soujanya957/capstan-drive-leg/(list of files, cad)

Other CAD files:
CapstanPedal/ref_cad/Capstan-Drive_local/Test_Stand_Assembly.stp
CapstanPedal/ref_cad/TOPS_local/TOPS CAD Assembly.stp
CapstanPedal/fullbuild_v5/single_leg/print/0_Fit_Coupon.stl
CapstanPedal/ref_cad/moteus_r4_placed_A.stl
CapstanPedal/v9_1_buildable/assembly/leg_abad_gantry.step
CapstanPedal/v9_1_buildable/step/abad/Hip_Post.step
CapstanPedal/v9_1_buildable/step/leg_4bar/Leg4_Coupler.step
CapstanPedal/v9_1_buildable/step/mounts/Desk_Angle_Rear.step
CapstanPedal/v9_1_buildable/step/Test_Arm_A.step
CapstanPedal/ref_cad/moteus_r4_placed_B.stl
CapstanPedal/v9_1_buildable/assembly/leg.step
CapstanPedal/v9_1_buildable/step/abad/Hip_Trunnion.step
CapstanPedal/v9_1_buildable/step/leg_4bar/Leg4_Crank_NoGantry.step
CapstanPedal/v9_1_buildable/step/mounts/Desk_Angle_Front.step
CapstanPedal/v9_1_buildable/step/Post.step
CapstanPedal/ref_cad/eaglepower_8308.step
CapstanPedal/v9_1_buildable/assembly/leg_abad.step
CapstanPedal/v9_1_buildable/step/abad/Hip_Inner_Plate.step
CapstanPedal/v9_1_buildable/step/Big_Drum_B.step
CapstanPedal/v9_1_buildable/step/leg_4bar/Leg4_Foot.step
CapstanPedal/v9_1_buildable/step/mounts/Rail_Carriage.step
CapstanPedal/v9_1_buildable/assembly/flange.step
CapstanPedal/v9_1_buildable/step/abad/Hip_Front_Plate.step
CapstanPedal/v9_1_buildable/step/End_Bracket.step
CapstanPedal/v9_1_buildable/step/leg_4bar/Leg4_Crank.step
CapstanPedal/v9_1_buildable/step/mounts/Desk_Base.step
CapstanPedal/v9_1_buildable/assembly/flange_abad.step
CapstanPedal/v9_1_buildable/step/abad/Hip_Outer_Plate.step
CapstanPedal/v9_1_buildable/step/leg_4bar/Leg4_Shin.step
CapstanPedal/v9_1_buildable/step/Motor_Plate.step
CapstanPedal/v9_1_buildable/assembly/leg_gantry.step
CapstanPedal/v9_1_buildable/step/abad/Hip_Spine.step
CapstanPedal/v9_1_buildable/step/Gantry_Post.step
CapstanPedal/v9_1_buildable/step/leg_4bar/Leg4_Foot_Core_A.step
CapstanPedal/v9_1_buildable/assembly/flange_abad_gantry.step
CapstanPedal/v9_1_buildable/step/abad/Abad_Small_Drum.step
CapstanPedal/v9_1_buildable/step/leg_4bar/Leg4_Shin_Plate_Back.step
CapstanPedal/v9_1_buildable/step/Output_Flange_A.step
CapstanPedal/v9_1_buildable/assembly/flange_gantry.step
CapstanPedal/v9_1_buildable/step/abad/Abad_Drum.step
CapstanPedal/v9_1_buildable/step/leg_4bar/Leg4_Shin_Plate_Front.step
CapstanPedal/v9_1_buildable/step/Small_Drum_B.step
CapstanPedal/v9_1_buildable/step/abad/End_Bracket_Front.step
CapstanPedal/v9_1_buildable/step/leg_4bar/Leg4_Foot_Core_B.step
CapstanPedal/v9_1_buildable/step/Small_Drum_A.step
CapstanPedal/v9_1_buildable/step/Big_Drum_A.step
CapstanPedal/v9_1_buildable/step/leg_4bar/Leg4_Thigh.step
CapstanPedal/v9_1_buildable/step/Gantry.step
CapstanPedal/v9_1_buildable/step/Front_Wall.step
CapstanPedal/v9_1_buildable/step/Output_Flange_B.step
CapstanPedal/v9_1_buildable/step/Top_Rail.step
CapstanPedal/v9_1_buildable/step/Test_Arm_A_Gantry.step
CapstanPedal/v9_1_buildable/step/A_Shaft_Cap.step
CapstanPedal/v9_1_buildable/step/Test_Arm_B.step
CapstanPedal/fullbuild_v3/urdf/meshes/coupler_LF__red.stl
CapstanPedal/fullbuild_v3/urdf/meshes/coupler_LR__red.stl
CapstanPedal/fullbuild_v3/urdf/meshes/coupler_RF__red.stl
CapstanPedal/fullbuild_v3/urdf/meshes/coupler_RR__red.stl
CapstanPedal/fullbuild_v3/urdf/meshes/crank_LF__brass.stl
CapstanPedal/fullbuild_v3/urdf/meshes/crank_LF__red.stl
CapstanPedal/fullbuild_v3/urdf/meshes/crank_LF__screw.stl
CapstanPedal/fullbuild_v3/urdf/meshes/crank_LF__steel.stl
CapstanPedal/fullbuild_v3/urdf/meshes/crank_LF__teal.stl
CapstanPedal/fullbuild_v3/urdf/meshes/crank_LR__brass.stl
CapstanPedal/fullbuild_v3/urdf/meshes/crank_LR__red.stl
CapstanPedal/fullbuild_v3/urdf/meshes/crank_LR__screw.stl
CapstanPedal/fullbuild_v3/urdf/meshes/crank_LR__steel.stl
CapstanPedal/fullbuild_v3/urdf/meshes/crank_LR__teal.stl
CapstanPedal/fullbuild_v3/urdf/meshes/crank_RF__brass.stl
CapstanPedal/fullbuild_v3/urdf/meshes/crank_RF__red.stl
CapstanPedal/fullbuild_v3/urdf/meshes/crank_RF__screw.stl
CapstanPedal/fullbuild_v3/urdf/meshes/crank_RF__steel.stl
CapstanPedal/fullbuild_v3/urdf/meshes/crank_RF__teal.stl
CapstanPedal/fullbuild_v3/urdf/meshes/crank_RR__brass.stl
CapstanPedal/fullbuild_v3/urdf/meshes/crank_RR__red.stl
CapstanPedal/fullbuild_v3/urdf/meshes/crank_RR__screw.stl
CapstanPedal/fullbuild_v3/urdf/meshes/crank_RR__steel.stl
CapstanPedal/fullbuild_v3/urdf/meshes/crank_RR__teal.stl
CapstanPedal/fullbuild_v3/urdf/meshes/pod_LF__black.stl
CapstanPedal/fullbuild_v3/urdf/meshes/pod_LF__brass.stl
CapstanPedal/fullbuild_v3/urdf/meshes/pod_LF__dimgray.stl
CapstanPedal/fullbuild_v3/urdf/meshes/pod_LF__motor_dark.stl
CapstanPedal/fullbuild_v3/urdf/meshes/pod_LF__red.stl
CapstanPedal/fullbuild_v3/urdf/meshes/pod_LF__screw.stl
CapstanPedal/fullbuild_v3/urdf/meshes/pod_LF__steel.stl
CapstanPedal/fullbuild_v3/urdf/meshes/pod_LF__violet.stl
CapstanPedal/fullbuild_v3/urdf/meshes/pod_LR__black.stl
CapstanPedal/fullbuild_v3/urdf/meshes/pod_LR__brass.stl
CapstanPedal/fullbuild_v3/urdf/meshes/pod_LR__dimgray.stl
CapstanPedal/fullbuild_v3/urdf/meshes/pod_LR__motor_dark.stl
CapstanPedal/fullbuild_v3/urdf/meshes/pod_LR__red.stl
CapstanPedal/fullbuild_v3/urdf/meshes/pod_LR__screw.stl
CapstanPedal/fullbuild_v3/urdf/meshes/pod_LR__steel.stl
CapstanPedal/fullbuild_v3/urdf/meshes/pod_LR__violet.stl
CapstanPedal/fullbuild_v3/urdf/meshes/pod_RF__black.stl
CapstanPedal/fullbuild_v3/urdf/meshes/pod_RF__brass.stl
CapstanPedal/fullbuild_v3/urdf/meshes/pod_RF__dimgray.stl
CapstanPedal/fullbuild_v3/urdf/meshes/pod_RF__motor_dark.stl
CapstanPedal/fullbuild_v3/urdf/meshes/pod_RF__red.stl
CapstanPedal/fullbuild_v3/urdf/meshes/pod_RF__screw.stl
CapstanPedal/fullbuild_v3/urdf/meshes/pod_RF__steel.stl
CapstanPedal/fullbuild_v3/urdf/meshes/pod_RF__violet.stl
CapstanPedal/fullbuild_v3/urdf/meshes/pod_RR__black.stl
CapstanPedal/fullbuild_v3/urdf/meshes/pod_RR__brass.stl
CapstanPedal/fullbuild_v3/urdf/meshes/pod_RR__dimgray.stl
CapstanPedal/fullbuild_v3/urdf/meshes/pod_RR__motor_dark.stl
CapstanPedal/fullbuild_v3/urdf/meshes/pod_RR__red.stl
CapstanPedal/fullbuild_v3/urdf/meshes/pod_RR__screw.stl
CapstanPedal/fullbuild_v3/urdf/meshes/pod_RR__steel.stl
CapstanPedal/fullbuild_v3/urdf/meshes/pod_RR__violet.stl
CapstanPedal/fullbuild_v3/urdf/meshes/rotorA_LF__magnet.stl
CapstanPedal/fullbuild_v3/urdf/meshes/rotorA_LF__motor.stl
CapstanPedal/fullbuild_v3/urdf/meshes/rotorA_LF__screw.stl
CapstanPedal/fullbuild_v3/urdf/meshes/rotorA_LF__silver.stl
CapstanPedal/fullbuild_v3/urdf/meshes/rotorA_LF__steel.stl
CapstanPedal/fullbuild_v3/urdf/meshes/rotorA_LR__magnet.stl
CapstanPedal/fullbuild_v3/urdf/meshes/rotorA_LR__motor.stl
CapstanPedal/fullbuild_v3/urdf/meshes/rotorA_LR__screw.stl
CapstanPedal/fullbuild_v3/urdf/meshes/rotorA_LR__silver.stl
CapstanPedal/fullbuild_v3/urdf/meshes/rotorA_LR__steel.stl
CapstanPedal/fullbuild_v3/urdf/meshes/rotorA_RF__magnet.stl
CapstanPedal/fullbuild_v3/urdf/meshes/rotorA_RF__motor.stl
CapstanPedal/fullbuild_v3/urdf/meshes/rotorA_RF__screw.stl
CapstanPedal/fullbuild_v3/urdf/meshes/rotorA_RF__silver.stl
CapstanPedal/fullbuild_v3/urdf/meshes/rotorA_RF__steel.stl
CapstanPedal/fullbuild_v3/urdf/meshes/rotorA_RR__magnet.stl
CapstanPedal/fullbuild_v3/urdf/meshes/rotorA_RR__motor.stl
CapstanPedal/fullbuild_v3/urdf/meshes/rotorA_RR__screw.stl
CapstanPedal/fullbuild_v3/urdf/meshes/rotorA_RR__silver.stl
CapstanPedal/fullbuild_v3/urdf/meshes/rotorA_RR__steel.stl
CapstanPedal/fullbuild_v3/urdf/meshes/rotorB_LF__magnet.stl
CapstanPedal/fullbuild_v3/urdf/meshes/rotorB_LF__motor.stl
CapstanPedal/fullbuild_v3/urdf/meshes/rotorB_LF__screw.stl
CapstanPedal/fullbuild_v3/urdf/meshes/rotorB_LF__silver.stl
CapstanPedal/fullbuild_v3/urdf/meshes/rotorB_LF__steel.stl
CapstanPedal/fullbuild_v3/urdf/meshes/rotorB_LR__magnet.stl
CapstanPedal/fullbuild_v3/urdf/meshes/rotorB_LR__motor.stl
CapstanPedal/fullbuild_v3/urdf/meshes/rotorB_LR__screw.stl
CapstanPedal/fullbuild_v3/urdf/meshes/rotorB_LR__silver.stl
CapstanPedal/fullbuild_v3/urdf/meshes/rotorB_LR__steel.stl
CapstanPedal/fullbuild_v3/urdf/meshes/rotorB_RF__magnet.stl
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
