soujanya957/capstan-drive-leg/CapstanPedal/fullbuild_v4/urdf/capstan_quad.urdf

<?xml version="1.0"?>
<!-- Capstan quadruped v3 (v9.1 legs): generated by build_urdf.py from the CAD -->
<robot name="capstan_quad">
  <material name="amber"><color rgba="0.930 0.520 0.120 1.0"/></material>
  <material name="black"><color rgba="0.110 0.110 0.120 1.0"/></material>
  <material name="blue"><color rgba="0.120 0.300 0.850 1.0"/></material>
  <material name="brass"><color rgba="0.860 0.660 0.280 1.0"/></material>
  <material name="cf"><color rgba="0.090 0.090 0.100 1.0"/></material>
  <material name="dimgray"><color rgba="0.380 0.390 0.410 1.0"/></material>
  <material name="magnet"><color rgba="0.720 0.730 0.760 1.0"/></material>
  <material name="motor"><color rgba="0.740 0.550 0.200 1.0"/></material>
  <material name="motor_dark"><color rgba="0.300 0.300 0.320 1.0"/></material>
  <material name="pcb"><color rgba="0.150 0.450 0.300 1.0"/></material>
  <material name="purple"><color rgba="0.360 0.200 0.550 1.0"/></material>
  <material name="red"><color rgba="0.800 0.220 0.170 1.0"/></material>
  <material name="screw"><color rgba="0.800 0.810 0.840 1.0"/></material>
  <material name="silver"><color rgba="0.800 0.810 0.830 1.0"/></material>
  <material name="steel"><color rgba="0.620 0.660 0.720 1.0"/></material>
  <material name="teal"><color rgba="0.100 0.560 0.580 1.0"/></material>
  <material name="violet"><color rgba="0.470 0.320 0.700 1.0"/></material>
  <material name="white"><color rgba="0.930 0.930 0.900 1.0"/></material>
  <material name="yellow"><color rgba="0.930 0.740 0.180 1.0"/></material>
  <link name="torso">
    <inertial><origin xyz="-0.00001 0.00117 -0.01315"/><mass value="5.6471"/><inertia ixx="0.0662936" ixy="4.0156e-06" ixz="-1.92121e-06" iyy="0.130849" iyz="-1.42409e-05" izz="0.146887"/></inertial>
    <visual><geometry><mesh filename="meshes/torso__black.obj"/></geometry><material name="black"/></visual>
    <visual><geometry><mesh filename="meshes/torso__blue.obj"/></geometry><material name="blue"/></visual>
    <visual><geometry><mesh filename="meshes/torso__brass.obj"/></geometry><material name="brass"/></visual>
    <visual><geometry><mesh filename="meshes/torso__cf.obj"/></geometry><material name="cf"/></visual>
    <visual><geometry><mesh filename="meshes/torso__dimgray.obj"/></geometry><material name="dimgray"/></visual>
    <visual><geometry><mesh filename="meshes/torso__motor_dark.obj"/></geometry><material name="motor_dark"/></visual>
    <visual><geometry><mesh filename="meshes/torso__pcb.obj"/></geometry><material name="pcb"/></visual>
    <visual><geometry><mesh filename="meshes/torso__purple.obj"/></geometry><material name="purple"/></visual>
    <visual><geometry><mesh filename="meshes/torso__red.obj"/></geometry><material name="red"/></visual>
    <visual><geometry><mesh filename="meshes/torso__screw.obj"/></geometry><material name="screw"/></visual>
    <visual><geometry><mesh filename="meshes/torso__silver.obj"/></geometry><material name="silver"/></visual>
    <visual><geometry><mesh filename="meshes/torso__steel.obj"/></geometry><material name="steel"/></visual>
    <visual><geometry><mesh filename="meshes/torso__white.obj"/></geometry><material name="white"/></visual>
    <visual><geometry><mesh filename="meshes/torso__yellow.obj"/></geometry><material name="yellow"/></visual>
    <collision><origin xyz="0 0 -0.0325"/><geometry><box size="0.69 0.26 0.22"/></geometry></collision>
  </link>
  <link name="pod_LF">
    <inertial><origin xyz="-0.01137 -0.00158 0.04767"/><mass value="2.4610"/><inertia ixx="0.00820475" ixy="0.00047916" ixz="-0.000741235" iyy="0.0148086" iyz="0.00055981" izz="0.0150834"/></inertial>
    <visual><geometry><mesh filename="meshes/pod_LF__black.obj"/></geometry><material name="black"/></visual>
    <visual><geometry><mesh filename="meshes/pod_LF__brass.obj"/></geometry><material name="brass"/></visual>
    <visual><geometry><mesh filename="meshes/pod_LF__dimgray.obj"/></geometry><material name="dimgray"/></visual>
    <visual><geometry><mesh filename="meshes/pod_LF__motor_dark.obj"/></geometry><material name="motor_dark"/></visual>
    <visual><geometry><mesh filename="meshes/pod_LF__red.obj"/></geometry><material name="red"/></visual>
    <visual><geometry><mesh filename="meshes/pod_LF__screw.obj"/></geometry><material name="screw"/></visual>
    <visual><geometry><mesh filename="meshes/pod_LF__steel.obj"/></geometry><material name="steel"/></visual>
    <visual><geometry><mesh filename="meshes/pod_LF__violet.obj"/></geometry><material name="violet"/></visual>
    <collision><origin xyz="-0.0315 0.0140 0.0300"/><geometry><box size="0.26 0.10 0.17"/></geometry></collision>
  </link>
  <link name="thigh_LF">
    <inertial><origin xyz="0.03341 -0.02143 -0.05619"/><mass value="0.2851"/><inertia ixx="0.00195796" ixy="-0.00016787" ixz="0.000971859" iyy="0.00258889" iyz="0.00030171" izz="0.000858487"/></inertial>
    <visual><geometry><mesh filename="meshes/thigh_LF__amber.obj"/></geometry><material name="amber"/></visual>
    <visual><geometry><mesh filename="meshes/thigh_LF__black.obj"/></geometry><material name="black"/></visual>
    <visual><geometry><mesh filename="meshes/thigh_LF__brass.obj"/></geometry><material name="brass"/></visual>
    <visual><geometry><mesh filename="meshes/thigh_LF__red.obj"/></geometry><material name="red"/></visual>
    <visual><geometry><mesh filename="meshes/thigh_LF__screw.obj"/></geometry><material name="screw"/></visual>
    <visual><geometry><mesh filename="meshes/thigh_LF__steel.obj"/></geometry><material name="steel"/></visual>
    <collision><origin xyz="0.05000 0.00000 -0.08660" rpy="0 2.61799 0"/><geometry><cylinder radius="0.014" length="0.20000"/></geometry></collision>
  </link>
  <link name="crank_LF">
    <inertial><origin xyz="0.00621 -0.04210 0.00658"/><mass value="0.2398"/><inertia ixx="0.00064813" ixy="-9.52676e-05" ixz="-7.57725e-05" iyy="0.000393976" iyz="-6.97606e-05" izz="0.000693556"/></inertial>
    <visual><geometry><mesh filename="meshes/crank_LF__brass.obj"/></geometry><material name="brass"/></visual>
    <visual><geometry><mesh filename="meshes/crank_LF__red.obj"/></geometry><material name="red"/></visual>
    <visual><geometry><mesh filename="meshes/crank_LF__screw.obj"/></geometry><material name="screw"/></visual>
    <visual><geometry><mesh filename="meshes/crank_LF__steel.obj"/></geometry><material name="steel"/></visual>
    <visual><geometry><mesh filename="meshes/crank_LF__teal.obj"/></geometry><material name="teal"/></visual>
  </link>
  <link name="rotorA_LF">
    <inertial><mass value="0.001"/><inertia ixx="1e-7" ixy="0" ixz="0" iyy="1e-7" iyz="0" izz="1e-7"/></inertial>
    <visual><geometry><mesh filename="meshes/rotorA_LF__magnet.obj"/></geometry><material name="magnet"/></visual>
    <visual><geometry><mesh filename="meshes/rotorA_LF__motor.obj"/></geometry><material name="motor"/></visual>
    <visual><geometry><mesh filename="meshes/rotorA_LF__screw.obj"/></geometry><material name="screw"/></visual>
    <visual><geometry><mesh filename="meshes/rotorA_LF__silver.obj"/></geometry><material name="silver"/></visual>
    <visual><geometry><mesh filename="meshes/rotorA_LF__steel.obj"/></geometry><material name="steel"/></visual>
  </link>
  <link name="rotorB_LF">
    <inertial><mass value="0.001"/><inertia ixx="1e-7" ixy="0" ixz="0" iyy="1e-7" iyz="0" izz="1e-7"/></inertial>
    <visual><geometry><mesh filename="meshes/rotorB_LF__magnet.obj"/></geometry><material name="magnet"/></visual>
    <visual><geometry><mesh filename="meshes/rotorB_LF__motor.obj"/></geometry><material name="motor"/></visual>
    <visual><geometry><mesh filename="meshes/rotorB_LF__screw.obj"/></geometry><material name="screw"/></visual>
    <visual><geometry><mesh filename="meshes/rotorB_LF__silver.obj"/></geometry><material name="silver"/></visual>
    <visual><geometry><mesh filename="meshes/rotorB_LF__steel.obj"/></geometry><material name="steel"/></visual>
  </link>
  <link name="rotorC_LF">
    <inertial><mass value="0.001"/><inertia ixx="1e-7" ixy="0" ixz="0" iyy="1e-7" iyz="0" izz="1e-7"/></inertial>
    <visual><geometry><mesh filename="meshes/rotorC_LF__magnet.obj"/></geometry><material name="magnet"/></visual>
    <visual><geometry><mesh filename="meshes/rotorC_LF__motor.obj"/></geometry><material name="motor"/></visual>
    <visual><geometry><mesh filename="meshes/rotorC_LF__screw.obj"/></geometry><material name="screw"/></visual>
    <visual><geometry><mesh filename="meshes/rotorC_LF__silver.obj"/></geometry><material name="silver"/></visual>
    <visual><geometry><mesh filename="meshes/rotorC_LF__steel.obj"/></geometry><material name="steel"/></visual>
  </link>
  <link name="coupler_LF">
    <inertial><origin xyz="0.06061 0.01509 -0.10083"/><mass value="0.0572"/><inertia ixx="0.00013777" ixy="4.23738e-07" ixz="6.66021e-05" iyy="0.000179031" iyz="-9.49691e-07" izz="4.23388e-05"/></inertial>
    <visual><geometry><mesh filename="meshes/coupler_LF__red.obj"/></geometry><material name="red"/></visual>
  </link>
  <link name="shin_LF">
    <inertial><origin xyz="-0.05754 -0.00033 -0.10353"/><mass value="0.2235"/><inertia ixx="0.00164671" ixy="-1.44123e-05" ixz="-0.00104536" iyy="0.00234251" iyz="-2.04071e-05" izz="0.000729452"/></inertial>
    <visual><geometry><mesh filename="meshes/shin_LF__black.obj"/></geometry><material name="black"/></visual>
    <visual><geometry><mesh filename="meshes/shin_LF__brass.obj"/></geometry><material name="brass"/></visual>
    <visual><geometry><mesh filename="meshes/shin_LF__dimgray.obj"/></geometry><material name="dimgray"/></visual>
    <visual><geometry><mesh filename="meshes/shin_LF__red.obj"/></geometry><material name="red"/></visual>
    <visual><geometry><mesh filename="meshes/shin_LF__screw.obj"/></geometry><material name="screw"/></visual>
    <visual><geometry><mesh filename="meshes/shin_LF__steel.obj"/></geometry><material name="steel"/></visual>
    <collision><origin xyz="-0.04250 0.00000 -0.07361" rpy="0 -2.61799 0"/><geometry><cylinder radius="0.012" length="0.17000"/></geometry></collision>
    <collision name="foot_LF"><origin xyz="-0.10000 0 -0.17321"/><geometry><sphere radius="0.023"/></geometry></collision>
  </link>
  <link name="pod_LR">
    <inertial><origin xyz="0.00733 -0.00158 0.04767"/><mass value="2.4610"/><inertia ixx="0.00820475" ixy="0.000372214" ixz="0.000669965" iyy="0.0149946" iyz="0.00055981" izz="0.0152693"/></inertial>
    <visual><geometry><mesh filename="meshes/pod_LR__black.obj"/></geometry><material name="black"/></visual>
    <visual><geometry><mesh filename="meshes/pod_LR__brass.obj"/></geometry><material name="brass"/></visual>
    <visual><geometry><mesh filename="meshes/pod_LR__dimgray.obj"/></geometry><material name="dimgray"/></visual>
    <visual><geometry><mesh filename="meshes/pod_LR__motor_dark.obj"/></geometry><material name="motor_dark"/></visual>
    <visual><geometry><mesh filename="meshes/pod_LR__red.obj"/></geometry><material name="red"/></visual>
    <visual><geometry><mesh filename="meshes/pod_LR__screw.obj"/></geometry><material name="screw"/></visual>
    <visual><geometry><mesh filename="meshes/pod_LR__steel.obj"/></geometry><material name="steel"/></visual>
    <visual><geometry><mesh filename="meshes/pod_LR__violet.obj"/></geometry><material name="violet"/></visual>
    <collision><origin xyz="0.0315 0.0140 0.0300"/><geometry><box size="0.26 0.10 0.17"/></geometry></collision>
  </link>
  <link name="thigh_LR">
    <inertial><origin xyz="0.03341 -0.02143 -0.05619"/><mass value="0.2851"/><inertia ixx="0.00195796" ixy="-0.00016787" ixz="0.000971859" iyy="0.00258889" iyz="0.00030171" izz="0.000858487"/></inertial>
    <visual><geometry><mesh filename="meshes/thigh_LR__amber.obj"/></geometry><material name="amber"/></visual>
    <visual><geometry><mesh filename="meshes/thigh_LR__black.obj"/></geometry><material name="black"/></visual>
    <visual><geometry><mesh filename="meshes/thigh_LR__brass.obj"/></geometry><material name="brass"/></visual>
    <visual><geometry><mesh filename="meshes/thigh_LR__red.obj"/></geometry><material name="red"/></visual>
    <visual><geometry><mesh filename="meshes/thigh_LR__screw.obj"/></geometry><material name="screw"/></visual>
    <visual><geometry><mesh filename="meshes/thigh_LR__steel.obj"/></geometry><material name="steel"/></visual>
    <collision><origin xyz="0.05000 0.00000 -0.08660" rpy="0 2.61799 0"/><geometry><cylinder radius="0.014" length="0.20000"/></geometry></collision>
  </link>
  <link name="crank_LR">
    <inertial><origin xyz="0.00621 -0.04210 0.00658"/><mass value="0.2398"/><inertia ixx="0.00064813" ixy="-9.52676e-05" ixz="-7.57725e-05" iyy="0.000393976" iyz="-6.97606e-05" izz="0.000693556"/></inertial>
    <visual><geometry><mesh filename="meshes/crank_LR__brass.obj"/></geometry><material name="brass"/></visual>
    <visual><geometry><mesh filename="meshes/crank_LR__red.obj"/></geometry><material name="red"/></visual>
    <visual><geometry><mesh filename="meshes/crank_LR__screw.obj"/></geometry><material name="screw"/></visual>
    <visual><geometry><mesh filename="meshes/crank_LR__steel.obj"/></geometry><material name="steel"/></visual>
    <visual><geometry><mesh filename="meshes/crank_LR__teal.obj"/></geometry><material name="teal"/></visual>
  </link>
  <link name="rotorA_LR">
    <inertial><mass value="0.001"/><inertia ixx="1e-7" ixy="0" ixz="0" iyy="1e-7" iyz="0" izz="1e-7"/></inertial>
    <visual><geometry><mesh filename="meshes/rotorA_LR__magnet.obj"/></geometry><material name="magnet"/></visual>
    <visual><geometry><mesh filename="meshes/rotorA_LR__motor.obj"/></geometry><material name="motor"/></visual>
    <visual><geometry><mesh filename="meshes/rotorA_LR__screw.obj"/></geometry><material name="screw"/></visual>
    <visual><geometry><mesh filename="meshes/rotorA_LR__silver.obj"/></geometry><material name="silver"/></visual>
    <visual><geometry><mesh filename="meshes/rotorA_LR__steel.obj"/></geometry><material name="steel"/></visual>
  </link>
  <link name="rotorB_LR">
    <inertial><mass value="0.001"/><inertia ixx="1e-7" ixy="0" ixz="0" iyy="1e-7" iyz="0" izz="1e-7"/></inertial>
    <visual><geometry><mesh filename="meshes/rotorB_LR__magnet.obj"/></geometry><material name="magnet"/></visual>
    <visual><geometry><mesh filename="meshes/rotorB_LR__motor.obj"/></geometry><material name="motor"/></visual>
    <visual><geometry><mesh filename="meshes/rotorB_LR__screw.obj"/></geometry><material name="screw"/></visual>
    <visual><geometry><mesh filename="meshes/rotorB_LR__silver.obj"/></geometry><material name="silver"/></visual>
    <visual><geometry><mesh filename="meshes/rotorB_LR__steel.obj"/></geometry><material name="steel"/></visual>
  </link>
  <link name="rotorC_LR">
    <inertial><mass value="0.001"/><inertia ixx="1e-7" ixy="0" ixz="0" iyy="1e-7" iyz="0" izz="1e-7"/></inertial>
    <visual><geometry><mesh filename="meshes/rotorC_LR__magnet.obj"/></geometry><material name="magnet"/></visual>
    <visual><geometry><mesh filename="meshes/rotorC_LR__motor.obj"/></geometry><material name="motor"/></visual>
    <visual><geometry><mesh filename="meshes/rotorC_LR__screw.obj"/></geometry><material name="screw"/></visual>
    <visual><geometry><mesh filename="meshes/rotorC_LR__silver.obj"/></geometry><material name="silver"/></visual>
    <visual><geometry><mesh filename="meshes/rotorC_LR__steel.obj"/></geometry><material name="steel"/></visual>
  </link>
  <link name="coupler_LR">
    <inertial><origin xyz="0.06061 0.01509 -0.10083"/><mass value="0.0572"/><inertia ixx="0.00013777" ixy="4.23738e-07" ixz="6.66021e-05" iyy="0.000179031" iyz="-9.49691e-07" izz="4.23388e-05"/></inertial>
    <visual><geometry><mesh filename="meshes/coupler_LR__red.obj"/></geometry><material name="red"/></visual>
  </link>
  <link name="shin_LR">
    <inertial><origin xyz="-0.05754 -0.00033 -0.10353"/><mass value="0.2235"/><inertia ixx="0.00164671" ixy="-1.44123e-05" ixz="-0.00104536" iyy="0.00234251" iyz="-2.04071e-05" izz="0.000729452"/></inertial>
    <visual><geometry><mesh filename="meshes/shin_LR__black.obj"/></geometry><material name="black"/></visual>
    <visual><geometry><mesh filename="meshes/shin_LR__brass.obj"/></geometry><material name="brass"/></visual>
    <visual><geometry><mesh filename="meshes/shin_LR__dimgray.obj"/></geometry><material name="dimgray"/></visual>
    <visual><geometry><mesh filename="meshes/shin_LR__red.obj"/></geometry><material name="red"/></visual>
    <visual><geometry><mesh filename="meshes/shin_LR__screw.obj"/></geometry><material name="screw"/></visual>
    <visual><geometry><mesh filename="meshes/shin_LR__steel.obj"/></geometry><material name="steel"/></visual>
    <collision><origin xyz="-0.04250 0.00000 -0.07361" rpy="0 -2.61799 0"/><geometry><cylinder radius="0.012" length="0.17000"/></geometry></collision>
    <collision name="foot_LR"><origin xyz="-0.10000 0 -0.17321"/><geometry><sphere radius="0.023"/></geometry></collision>
  </link>
  <link name="pod_RF">
    <inertial><origin xyz="-0.01137 0.00158 0.04767"/><mass value="2.4610"/><inertia ixx="0.00820475" ixy="-0.00047916" ixz="-0.000741235" iyy="0.0148086" iyz="-0.00055981" izz="0.0150834"/></inertial>
    <visual><geometry><mesh filename="meshes/pod_RF__black.obj"/></geometry><material name="black"/></visual>
    <visual><geometry><mesh filename="meshes/pod_RF__brass.obj"/></geometry><material name="brass"/></visual>
    <visual><geometry><mesh filename="meshes/pod_RF__dimgray.obj"/></geometry><material name="dimgray"/></visual>
    <visual><geometry><mesh filename="meshes/pod_RF__motor_dark.obj"/></geometry><material name="motor_dark"/></visual>
    <visual><geometry><mesh filename="meshes/pod_RF__red.obj"/></geometry><material name="red"/></visual>
    <visual><geometry><mesh filename="meshes/pod_RF__screw.obj"/></geometry><material name="screw"/></visual>
    <visual><geometry><mesh filename="meshes/pod_RF__steel.obj"/></geometry><material name="steel"/></visual>
    <visual><geometry><mesh filename="meshes/pod_RF__violet.obj"/></geometry><material name="violet"/></visual>
    <collision><origin xyz="-0.0315 -0.0140 0.0300"/><geometry><box size="0.26 0.10 0.17"/></geometry></collision>
  </link>
  <link name="thigh_RF">
    <inertial><origin xyz="0.03341 0.02143 -0.05619"/><mass value="0.2851"/><inertia ixx="0.00195796" ixy="0.00016787" ixz="0.000971859" iyy="0.00258889" iyz="-0.00030171" izz="0.000858487"/></inertial>
    <visual><geometry><mesh filename="meshes/thigh_RF__amber.obj"/></geometry><material name="amber"/></visual>
    <visual><geometry><mesh filename="meshes/thigh_RF__black.obj"/></geometry><material name="black"/></visual>
    <visual><geometry><mesh filename="meshes/thigh_RF__brass.obj"/></geometry><material name="brass"/></visual>
    <visual><geometry><mesh filename="meshes/thigh_RF__red.obj"/></geometry><material name="red"/></visual>
    <visual><geometry><mesh filename="meshes/thigh_RF__screw.obj"/></geometry><material name="screw"/></visual>
    <visual><geometry><mesh filename="meshes/thigh_RF__steel.obj"/></geometry><material name="steel"/></visual>
    <collision><origin xyz="0.05000 0.00000 -0.08660" rpy="0 2.61799 0"/><geometry><cylinder radius="0.014" length="0.20000"/></geometry></collision>
  </link>
  <link name="crank_RF">
    <inertial><origin xyz="0.00621 0.04210 0.00658"/><mass value="0.2398"/><inertia ixx="0.00064813" ixy="9.52676e-05" ixz="-7.57725e-05" iyy="0.000393976" iyz="6.97606e-05" izz="0.000693556"/></inertial>
    <visual><geometry><mesh filename="meshes/crank_RF__brass.obj"/></geometry><material name="brass"/></visual>
    <visual><geometry><mesh filename="meshes/crank_RF__red.obj"/></geometry><material name="red"/></visual>
    <visual><geometry><mesh filename="meshes/crank_RF__screw.obj"/></geometry><material name="screw"/></visual>
    <visual><geometry><mesh filename="meshes/crank_RF__steel.obj"/></geometry><material name="steel"/></visual>
    <visual><geometry><mesh filename="meshes/crank_RF__teal.obj"/></geometry><material name="teal"/></visual>
  </link>
  <link name="rotorA_RF">
    <inertial><mass value="0.001"/><inertia ixx="1e-7" ixy="0" ixz="0" iyy="1e-7" iyz="0" izz="1e-7"/></inertial>
    <visual><geometry><mesh filename="meshes/rotorA_RF__magnet.obj"/></geometry><material name="magnet"/></visual>
    <visual><geometry><mesh filename="meshes/rotorA_RF__motor.obj"/></geometry><material name="motor"/></visual>
    <visual><geometry><mesh filename="meshes/rotorA_RF__screw.obj"/></geometry><material name="screw"/></visual>
    <visual><geometry><mesh filename="meshes/rotorA_RF__silver.obj"/></geometry><material name="silver"/></visual>
    <visual><geometry><mesh filename="meshes/rotorA_RF__steel.obj"/></geometry><material name="steel"/></visual>
  </link>
  <link name="rotorB_RF">
    <inertial><mass value="0.001"/><inertia ixx="1e-7" ixy="0" ixz="0" iyy="1e-7" iyz="0" izz="1e-7"/></inertial>
    <visual><geometry><mesh filename="meshes/rotorB_RF__magnet.obj"/></geometry><material name="magnet"/></visual>
    <visual><geometry><mesh filename="meshes/rotorB_RF__motor.obj"/></geometry><material name="motor"/></visual>
    <visual><geometry><mesh filename="meshes/rotorB_RF__screw.obj"/></geometry><material name="screw"/></visual>
    <visual><geometry><mesh filename="meshes/rotorB_RF__silver.obj"/></geometry><material name="silver"/></visual>
    <visual><geometry><mesh filename="meshes/rotorB_RF__steel.obj"/></geometry><material name="steel"/></visual>
  </link>
  <link name="rotorC_RF">
    <inertial><mass value="0.001"/><inertia ixx="1e-7" ixy="0" ixz="0" iyy="1e-7" iyz="0" izz="1e-7"/></inertial>
    <visual><geometry><mesh filename="meshes/rotorC_RF__magnet.obj"/></geometry><material name="magnet"/></visual>
    <visual><geometry><mesh filename="meshes/rotorC_RF__motor.obj"/></geometry><material name="motor"/></visual>
    <visual><geometry><mesh filename="meshes/rotorC_RF__screw.obj"/></geometry><material name="screw"/></visual>
    <visual><geometry><mesh filename="meshes/rotorC_RF__silver.obj"/></geometry><material name="silver"/></visual>
    <visual><geometry><mesh filename="meshes/rotorC_RF__steel.obj"/></geometry><material name="steel"/></visual>
  </link>
  <link name="coupler_RF">
    <inertial><origin xyz="0.06061 -0.01509 -0.10083"/><mass value="0.0572"/><inertia ixx="0.00013777" ixy="-4.23738e-07" ixz="6.66021e-05" iyy="0.000179031" iyz="9.49691e-07" izz="4.23388e-05"/></inertial>
    <visual><geometry><mesh filename="meshes/coupler_RF__red.obj"/></geometry><material name="red"/></visual>
  </link>
  <link name="shin_RF">
    <inertial><origin xyz="-0.05754 0.00033 -0.10353"/><mass value="0.2235"/><inertia ixx="0.00164671" ixy="1.44123e-05" ixz="-0.00104536" iyy="0.00234251" iyz="2.04071e-05" izz="0.000729452"/></inertial>
    <visual><geometry><mesh filename="meshes/shin_RF__black.obj"/></geometry><material name="black"/></visual>
    <visual><geometry><mesh filename="meshes/shin_RF__brass.obj"/></geometry><material name="brass"/></visual>
    <visual><geometry><mesh filename="meshes/shin_RF__dimgray.obj"/></geometry><material name="dimgray"/></visual>
    <visual><geometry><mesh filename="meshes/shin_RF__red.obj"/></geometry><material name="red"/></visual>
    <visual><geometry><mesh filename="meshes/shin_RF__screw.obj"/></geometry><material name="screw"/></visual>
    <visual><geometry><mesh filename="meshes/shin_RF__steel.obj"/></geometry><material name="steel"/></visual>
    <collision><origin xyz="-0.04250 0.00000 -0.07361" rpy="0 -2.61799 0"/><geometry><cylinder radius="0.012" length="0.17000"/></geometry></collision>
    <collision name="foot_RF"><origin xyz="-0.10000 0 -0.17321"/><geometry><sphere radius="0.023"/></geometry></collision>
  </link>
  <link name="pod_RR">
    <inertial><origin xyz="0.00733 0.00158 0.04767"/><mass value="2.4610"/><inertia ixx="0.00820475" ixy="-0.000372214" ixz="0.000669965" iyy="0.0149946" iyz="-0.00055981" izz="0.0152693"/></inertial>
    <visual><geometry><mesh filename="meshes/pod_RR__black.obj"/></geometry><material name="black"/></visual>
    <visual><geometry><mesh filename="meshes/pod_RR__brass.obj"/></geometry><material name="brass"/></visual>
    <visual><geometry><mesh filename="meshes/pod_RR__dimgray.obj"/></geometry><material name="dimgray"/></visual>
    <visual><geometry><mesh filename="meshes/pod_RR__motor_dark.obj"/></geometry><material name="motor_dark"/></visual>
    <visual><geometry><mesh filename="meshes/pod_RR__red.obj"/></geometry><material name="red"/></visual>
    <visual><geometry><mesh filename="meshes/pod_RR__screw.obj"/></geometry><material name="screw"/></visual>
    <visual><geometry><mesh filename="meshes/pod_RR__steel.obj"/></geometry><material name="steel"/></visual>
    <visual><geometry><mesh filename="meshes/pod_RR__violet.obj"/></geometry><material name="violet"/></visual>
    <collision><origin xyz="0.0315 -0.0140 0.0300"/><geometry><box size="0.26 0.10 0.17"/></geometry></collision>
  </link>
  <link name="thigh_RR">
    <inertial><origin xyz="0.03341 0.02143 -0.05619"/><mass value="0.2851"/><inertia ixx="0.00195796" ixy="0.00016787" ixz="0.000971859" iyy="0.00258889" iyz="-0.00030171" izz="0.000858487"/></inertial>
    <visual><geometry><mesh filename="meshes/thigh_RR__amber.obj"/></geometry><material name="amber"/></visual>
    <visual><geometry><mesh filename="meshes/thigh_RR__black.obj"/></geometry><material name="black"/></visual>
    <visual><geometry><mesh filename="meshes/thigh_RR__brass.obj"/></geometry><material name="brass"/></visual>
    <visual><geometry><mesh filename="meshes/thigh_RR__red.obj"/></geometry><material name="red"/></visual>
    <visual><geometry><mesh filename="meshes/thigh_RR__screw.obj"/></geometry><material name="screw"/></visual>
    <visual><geometry><mesh filename="meshes/thigh_RR__steel.obj"/></geometry><material name="steel"/></visual>
    <collision><origin xyz="0.05000 0.00000 -0.08660" rpy="0 2.61799 0"/><geometry><cylinder radius="0.014" length="0.20000"/></geometry></collision>
  </link>
  <link name="crank_RR">
    <inertial><origin xyz="0.00621 0.04210 0.00658"/><mass value="0.2398"/><inertia ixx="0.00064813" ixy="9.52676e-05" ixz="-7.57725e-05" iyy="0.000393976" iyz="6.97606e-05" izz="0.000693556"/></inertial>
    <visual><geometry><mesh filename="meshes/crank_RR__brass.obj"/></geometry><material name="brass"/></visual>
    <visual><geometry><mesh filename="meshes/crank_RR__red.obj"/></geometry><material name="red"/></visual>
    <visual><geometry><mesh filename="meshes/crank_RR__screw.obj"/></geometry><material name="screw"/></visual>
    <visual><geometry><mesh filename="meshes/crank_RR__steel.obj"/></geometry><material name="steel"/></visual>
    <visual><geometry><mesh filename="meshes/crank_RR__teal.obj"/></geometry><material name="teal"/></visual>
  </link>
  <link name="rotorA_RR">
    <inertial><mass value="0.001"/><inertia ixx="1e-7" ixy="0" ixz="0" iyy="1e-7" iyz="0" izz="1e-7"/></inertial>
    <visual><geometry><mesh filename="meshes/rotorA_RR__magnet.obj"/></geometry><material name="magnet"/></visual>
    <visual><geometry><mesh filename="meshes/rotorA_RR__motor.obj"/></geometry><material name="motor"/></visual>
    <visual><geometry><mesh filename="meshes/rotorA_RR__screw.obj"/></geometry><material name="screw"/></visual>
    <visual><geometry><mesh filename="meshes/rotorA_RR__silver.obj"/></geometry><material name="silver"/></visual>
    <visual><geometry><mesh filename="meshes/rotorA_RR__steel.obj"/></geometry><material name="steel"/></visual>
  </link>
  <link name="rotorB_RR">
    <inertial><mass value="0.001"/><inertia ixx="1e-7" ixy="0" ixz="0" iyy="1e-7" iyz="0" izz="1e-7"/></inertial>
    <visual><geometry><mesh filename="meshes/rotorB_RR__magnet.obj"/></geometry><material name="magnet"/></visual>
    <visual><geometry><mesh filename="meshes/rotorB_RR__motor.obj"/></geometry><material name="motor"/></visual>
    <visual><geometry><mesh filename="meshes/rotorB_RR__screw.obj"/></geometry><material name="screw"/></visual>
    <visual><geometry><mesh filename="meshes/rotorB_RR__silver.obj"/></geometry><material name="silver"/></visual>
    <visual><geometry><mesh filename="meshes/rotorB_RR__steel.obj"/></geometry><material name="steel"/></visual>
  </link>
  <link name="rotorC_RR">
    <inertial><mass value="0.001"/><inertia ixx="1e-7" ixy="0" ixz="0" iyy="1e-7" iyz="0" izz="1e-7"/></inertial>
    <visual><geometry><mesh filename="meshes/rotorC_RR__magnet.obj"/></geometry><material name="magnet"/></visual>
    <visual><geometry><mesh filename="meshes/rotorC_RR__motor.obj"/></geometry><material name="motor"/></visual>
    <visual><geometry><mesh filename="meshes/rotorC_RR__screw.obj"/></geometry><material name="screw"/></visual>
    <visual><geometry><mesh filename="meshes/rotorC_RR__silver.obj"/></geometry><material name="silver"/></visual>
    <visual><geometry><mesh filename="meshes/rotorC_RR__steel.obj"/></geometry><material name="steel"/></visual>
  </link>
  <link name="coupler_RR">
    <inertial><origin xyz="0.06061 -0.01509 -0.10083"/><mass value="0.0572"/><inertia ixx="0.00013777" ixy="-4.23738e-07" ixz="6.66021e-05" iyy="0.000179031" iyz="9.49691e-07" izz="4.23388e-05"/></inertial>
    <visual><geometry><mesh filename="meshes/coupler_RR__red.obj"/></geometry><material name="red"/></visual>
  </link>
  <link name="shin_RR">
    <inertial><origin xyz="-0.05754 0.00033 -0.10353"/><mass value="0.2235"/><inertia ixx="0.00164671" ixy="1.44123e-05" ixz="-0.00104536" iyy="0.00234251" iyz="2.04071e-05" izz="0.000729452"/></inertial>
    <visual><geometry><mesh filename="meshes/shin_RR__black.obj"/></geometry><material name="black"/></visual>
    <visual><geometry><mesh filename="meshes/shin_RR__brass.obj"/></geometry><material name="brass"/></visual>
    <visual><geometry><mesh filename="meshes/shin_RR__dimgray.obj"/></geometry><material name="dimgray"/></visual>
    <visual><geometry><mesh filename="meshes/shin_RR__red.obj"/></geometry><material name="red"/></visual>
    <visual><geometry><mesh filename="meshes/shin_RR__screw.obj"/></geometry><material name="screw"/></visual>
    <visual><geometry><mesh filename="meshes/shin_RR__steel.obj"/></geometry><material name="steel"/></visual>
    <collision><origin xyz="-0.04250 0.00000 -0.07361" rpy="0 -2.61799 0"/><geometry><cylinder radius="0.012" length="0.17000"/></geometry></collision>
    <collision name="foot_RR"><origin xyz="-0.10000 0 -0.17321"/><geometry><sphere radius="0.023"/></geometry></collision>
  </link>
  <joint name="LF_abad" type="revolute">
    <parent link="torso"/><child link="pod_LF"/>
    <origin xyz="0.22150 0.08600 -0.06000"/><axis xyz="1 0 0"/>
    <limit lower="-0.20944" upper="0.20944" effort="31.5" velocity="23.3"/>
  </joint>
  <joint name="LF_hip" type="revolute">
    <parent link="pod_LF"/><child link="thigh_LF"/>
    <origin xyz="0.00000 0.07950 -0.00979"/><axis xyz="0 1 0"/>
    <limit lower="-1.57080" upper="1.57080" effort="31.5" velocity="23.3"/>
  </joint>
  <joint name="LF_crank" type="revolute">
    <parent link="pod_LF"/><child link="crank_LF"/>
    <origin xyz="0.00000 0.07950 -0.00979"/><axis xyz="0 1 0"/>
    <limit lower="-1.57080" upper="1.57080" effort="31.5" velocity="23.3"/>
  </joint>
  <joint name="LF_knee" type="revolute">
    <parent link="thigh_LF"/><child link="shin_LF"/>
    <origin xyz="0.10000 0.00000 -0.17321"/><axis xyz="0 1 0"/>
    <limit lower="-1.04720" upper="1.04720" effort="0" velocity="23.3"/>
  </joint>
  <joint name="LF_coupler" type="revolute">
    <parent link="crank_LF"/><child link="coupler_LF"/>
    <origin xyz="0.04213 0.00000 0.03535"/><axis xyz="0 1 0"/>
    <limit lower="-1.04720" upper="1.04720" effort="0" velocity="23.3"/>
  </joint>
  <joint name="LF_rotorA" type="revolute">
    <parent link="pod_LF"/><child link="rotorA_LF"/>
    <origin xyz="-0.04675 0.00000 0.06000"/><axis xyz="0 1 0"/>
    <limit lower="-174.53293" upper="174.53293" effort="3.5" velocity="210"/>
    <mimic joint="LF_crank" multiplier="-9"/>
  </joint>
  <joint name="LF_rotorB" type="revolute">
    <parent link="pod_LF"/><child link="rotorB_LF"/>
    <origin xyz="0.04675 0.00000 0.06000"/><axis xyz="0 1 0"/>
    <limit lower="-174.53293" upper="174.53293" effort="3.5" velocity="210"/>
    <mimic joint="LF_hip" multiplier="-9"/>
  </joint>
  <joint name="LF_rotorC" type="revolute">
    <parent link="torso"/><child link="rotorC_LF"/>
    <origin xyz="0.22150 0.08600 0.02400"/><axis xyz="1 0 0"/>
    <limit lower="-174.53293" upper="174.53293" effort="3.5" velocity="210"/>
    <mimic joint="LF_abad" multiplier="-9"/>
  </joint>
  <joint name="LR_abad" type="revolute">
    <parent link="torso"/><child link="pod_LR"/>
    <origin xyz="-0.22150 0.08600 -0.06000"/><axis xyz="1 0 0"/>
    <limit lower="-0.20944" upper="0.20944" effort="31.5" velocity="23.3"/>
  </joint>
  <joint name="LR_hip" type="revolute">
    <parent link="pod_LR"/><child link="thigh_LR"/>
    <origin xyz="0.00000 0.07950 -0.00979"/><axis xyz="0 1 0"/>
    <limit lower="-1.57080" upper="1.57080" effort="31.5" velocity="23.3"/>
  </joint>
  <joint name="LR_crank" type="revolute">
    <parent link="pod_LR"/><child link="crank_LR"/>
    <origin xyz="0.00000 0.07950 -0.00979"/><axis xyz="0 1 0"/>
    <limit lower="-1.57080" upper="1.57080" effort="31.5" velocity="23.3"/>
  </joint>
  <joint name="LR_knee" type="revolute">
    <parent link="thigh_LR"/><child link="shin_LR"/>
    <origin xyz="0.10000 0.00000 -0.17321"/><axis xyz="0 1 0"/>
    <limit lower="-1.04720" upper="1.04720" effort="0" velocity="23.3"/>
  </joint>
  <joint name="LR_coupler" type="revolute">
    <parent link="crank_LR"/><child link="coupler_LR"/>
    <origin xyz="0.04213 0.00000 0.03535"/><axis xyz="0 1 0"/>
    <limit lower="-1.04720" upper="1.04720" effort="0" velocity="23.3"/>
  </joint>
  <joint name="LR_rotorA" type="revolute">
    <parent link="pod_LR"/><child link="rotorA_LR"/>
    <origin xyz="-0.04675 0.00000 0.06000"/><axis xyz="0 1 0"/>
    <limit lower="-174.53293" upper="174.53293" effort="3.5" velocity="210"/>
    <mimic joint="LR_crank" multiplier="-9"/>
  </joint>
  <joint name="LR_rotorB" type="revolute">
    <parent link="pod_LR"/><child link="rotorB_LR"/>
    <origin xyz="0.04675 0.00000 0.06000"/><axis xyz="0 1 0"/>
    <limit lower="-174.53293" upper="174.53293" effort="3.5" velocity="210"/>
    <mimic joint="LR_hip" multiplier="-9"/>
  </joint>
  <joint name="LR_rotorC" type="revolute">
    <parent link="torso"/><child link="rotorC_LR"/>
    <origin xyz="-0.22150 0.08600 0.02400"/><axis xyz="1 0 0"/>
    <limit lower="-174.53293" upper="174.53293" effort="3.5" velocity="210"/>
    <mimic joint="LR_abad" multiplier="-9"/>
  </joint>
  <joint name="RF_abad" type="revolute">
    <parent link="torso"/><child link="pod_RF"/>
    <origin xyz="0.22150 -0.08600 -0.06000"/><axis xyz="1 0 0"/>
    <limit lower="-0.20944" upper="0.20944" effort="31.5" velocity="23.3"/>
  </joint>
  <joint name="RF_hip" type="revolute">
    <parent link="pod_RF"/><child link="thigh_RF"/>
    <origin xyz="0.00000 -0.07950 -0.00979"/><axis xyz="0 1 0"/>
    <limit lower="-1.57080" upper="1.57080" effort="31.5" velocity="23.3"/>
  </joint>
  <joint name="RF_crank" type="revolute">
    <parent link="pod_RF"/><child link="crank_RF"/>
    <origin xyz="0.00000 -0.07950 -0.00979"/><axis xyz="0 1 0"/>
    <limit lower="-1.57080" upper="1.57080" effort="31.5" velocity="23.3"/>
  </joint>
  <joint name="RF_knee" type="revolute">
    <parent link="thigh_RF"/><child link="shin_RF"/>
    <origin xyz="0.10000 0.00000 -0.17321"/><axis xyz="0 1 0"/>
    <limit lower="-1.04720" upper="1.04720" effort="0" velocity="23.3"/>
  </joint>
  <joint name="RF_coupler" type="revolute">
    <parent link="crank_RF"/><child link="coupler_RF"/>
    <origin xyz="0.04213 0.00000 0.03535"/><axis xyz="0 1 0"/>
    <limit lower="-1.04720" upper="1.04720" effort="0" velocity="23.3"/>
  </joint>
  <joint name="RF_rotorA" type="revolute">
    <parent link="pod_RF"/><child link="rotorA_RF"/>
    <origin xyz="-0.04675 0.00000 0.06000"/><axis xyz="0 1 0"/>
    <limit lower="-174.53293" upper="174.53293" effort="3.5" velocity="210"/>
    <mimic joint="RF_crank" multiplier="-9"/>
  </joint>
  <joint name="RF_rotorB" type="revolute">
    <parent link="pod_RF"/><child link="rotorB_RF"/>
    <origin xyz="0.04675 0.00000 0.06000"/><axis xyz="0 1 0"/>
    <limit lower="-174.53293" upper="174.53293" effort="3.5" velocity="210"/>
    <mimic joint="RF_hip" multiplier="-9"/>
  </joint>
  <joint name="RF_rotorC" type="revolute">
    <parent link="torso"/><child link="rotorC_RF"/>
    <origin xyz="0.22150 -0.08600 0.02400"/><axis xyz="1 0 0"/>
    <limit lower="-174.53293" upper="174.53293" effort="3.5" velocity="210"/>
    <mimic joint="RF_abad" multiplier="-9"/>
  </joint>
  <joint name="RR_abad" type="revolute">
    <parent link="torso"/><child link="pod_RR"/>
    <origin xyz="-0.22150 -0.08600 -0.06000"/><axis xyz="1 0 0"/>
    <limit lower="-0.20944" upper="0.20944" effort="31.5" velocity="23.3"/>
  </joint>
  <joint name="RR_hip" type="revolute">
    <parent link="pod_RR"/><child link="thigh_RR"/>
    <origin xyz="0.00000 -0.07950 -0.00979"/><axis xyz="0 1 0"/>
    <limit lower="-1.57080" upper="1.57080" effort="31.5" velocity="23.3"/>
  </joint>
  <joint name="RR_crank" type="revolute">
    <parent link="pod_RR"/><child link="crank_RR"/>
    <origin xyz="0.00000 -0.07950 -0.00979"/><axis xyz="0 1 0"/>
    <limit lower="-1.57080" upper="1.57080" effort="31.5" velocity="23.3"/>
  </joint>
  <joint name="RR_knee" type="revolute">
    <parent link="thigh_RR"/><child link="shin_RR"/>
    <origin xyz="0.10000 0.00000 -0.17321"/><axis xyz="0 1 0"/>
    <limit lower="-1.04720" upper="1.04720" effort="0" velocity="23.3"/>
  </joint>
  <joint name="RR_coupler" type="revolute">
    <parent link="crank_RR"/><child link="coupler_RR"/>
    <origin xyz="0.04213 0.00000 0.03535"/><axis xyz="0 1 0"/>
    <limit lower="-1.04720" upper="1.04720" effort="0" velocity="23.3"/>
  </joint>
  <joint name="RR_rotorA" type="revolute">
    <parent link="pod_RR"/><child link="rotorA_RR"/>
    <origin xyz="-0.04675 0.00000 0.06000"/><axis xyz="0 1 0"/>
    <limit lower="-174.53293" upper="174.53293" effort="3.5" velocity="210"/>
    <mimic joint="RR_crank" multiplier="-9"/>
  </joint>
  <joint name="RR_rotorB" type="revolute">
    <parent link="pod_RR"/><child link="rotorB_RR"/>
    <origin xyz="0.04675 0.00000 0.06000"/><axis xyz="0 1 0"/>
    <limit lower="-174.53293" upper="174.53293" effort="3.5" velocity="210"/>
    <mimic joint="RR_hip" multiplier="-9"/>
  </joint>
  <joint name="RR_rotorC" type="revolute">
    <parent link="torso"/><child link="rotorC_RR"/>
    <origin xyz="-0.22150 -0.08600 0.02400"/><axis xyz="1 0 0"/>
    <limit lower="-174.53293" upper="174.53293" effort="3.5" velocity="210"/>
    <mimic joint="RR_abad" multiplier="-9"/>
  </joint>
</robot>
