soujanya957/capstan-drive-leg/(commit log)

2026-10-19 Capstan drive leg v9.1 and quadruped v3: CAD, checks, RL, scripted jump, MuJoCo viewers
    [A_Shaft_Cap.step, A_Shaft_Cap.stl, A_Shaft_Cap__my.stl, Abad_Bearing_tip.stl, Abad_Bearing_tip__mx.stl, Abad_Bearing_tip__mxy.stl, Abad_Bearing_tip__my.stl, Abad_Bearings_6808.stl]
2026-10-19 URDF of the quadruped, model-based trot and jump controller, fast MuJoCo teleop; reference STEPs moved to ref_cad
    [coupler_LF__red.stl, coupler_LR__red.stl, coupler_RF__red.stl, coupler_RR__red.stl, crank_LF__brass.stl, crank_LF__red.stl, crank_LF__screw.stl, crank_LF__steel.stl]
2026-10-19 URDF: motor rotors on mimic joints, crank driven by output A, 4-bar closed in MuJoCo; limit-aware IK; five gaits; jump retuned
    [capstan_quad.urdf, pod_LF__magnet.stl, pod_LF__motor.stl, pod_LF__screw.stl, pod_LF__silver.stl, pod_LF__steel.stl, pod_LR__magnet.stl, pod_LR__motor.stl]
2026-10-19 fullbuild_v4: 30 mm narrower (ab/ad +-12), full X-truss plates, cradle plates clipped at the centreline, full-detail URDF meshes with creased normals, gaits and jump retuned, sim videos
    [A_Shaft_Cap.stl, A_Shaft_Cap__my.stl, Abad_Bearing_tip.stl, Abad_Bearing_tip__mx.stl, Abad_Bearing_tip__mxy.stl, Abad_Bearing_tip__my.stl, Abad_Bearings_6808.stl, Abad_Bearings_6808__mx.stl]
2026-10-19 fullbuild_v4 sim: horizon haze in the sky's colour (no white flicker), joint damping works on old and new mujoco
2026-10-19 fullbuild_v4: web export for the browser simulator, caption-free films, films re-rendered with the haze fix
    [make_videos.py]
2026-10-19 web/export_web.py: record drawn and CAD triangle counts in quad.json
2026-10-25 fullbuild_v4: RL controllers (rl/, rl2/) with real-sensor models, five deployable policies, experiment batches, robot check for new build versions, lessons and Codex review notes; optical-flow and ra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
2026-10-27 rl2: sighted FastSAC teacher with range sensor, RL Token residual, symmetry augmentation, queue9
2026-10-27 quadruped v5: belly battery pod (111 Wh, 23 min vs 9), head with Jetson and tilting ZED Mini / RealSense cradle, retuned jump, checks and stress
2026-11-03 v9.1/v5: two-part rigid foot core with snap-on TPU tread, single-leg bench kit (fullbuild_v5/single_leg) with films, assembly STEP export fixed
    [0_Fit_Coupon.stl, A_Shaft_Cap.step, Abad_Drum.step, Abad_Small_Drum.step, Big_Drum_A.step, Big_Drum_B.step, Desk_Angle_Front.step, Desk_Angle_Rear.step]
